rahuljeyaraj/spellbound-sweets/print/skull-nose.3mf

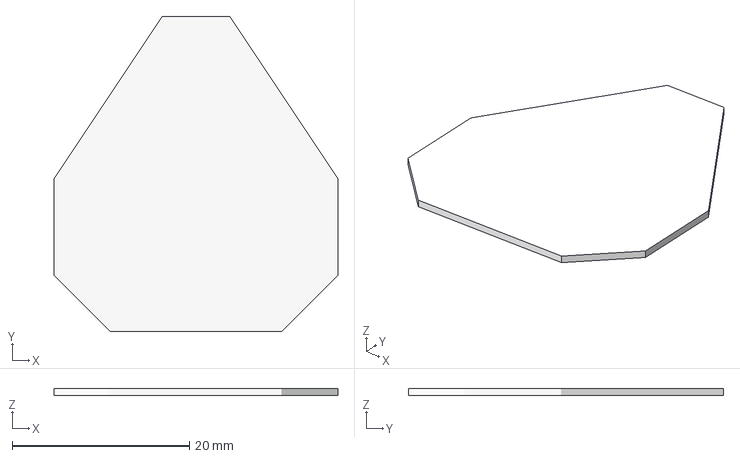
[picture p1: CAD file, 2026-11-06]
print/skull-nose.3mf
32.0 x 35.5 x 0.8 mm
