rahuljeyaraj/spellbound-sweets/print/skull-eye-led-right.3mf

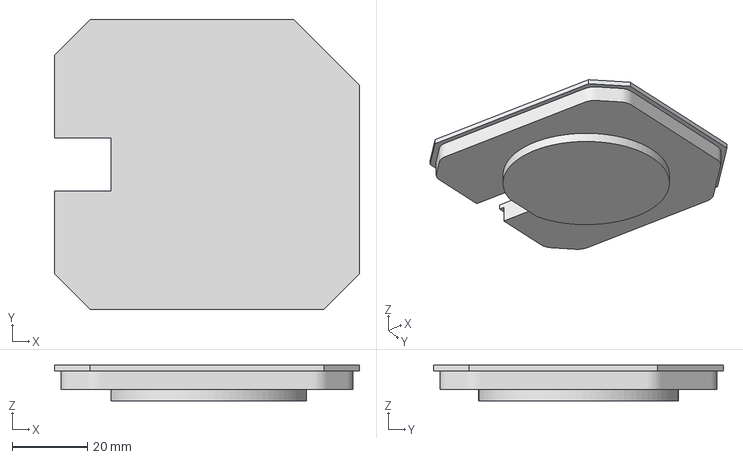
[picture p2: CAD file, 2026-11-06]
print/skull-eye-led-right.3mf
81.0 x 77.0 x 9.50 mm
