rahuljeyaraj/spellbound-sweets/print/skull-mouth.3mf

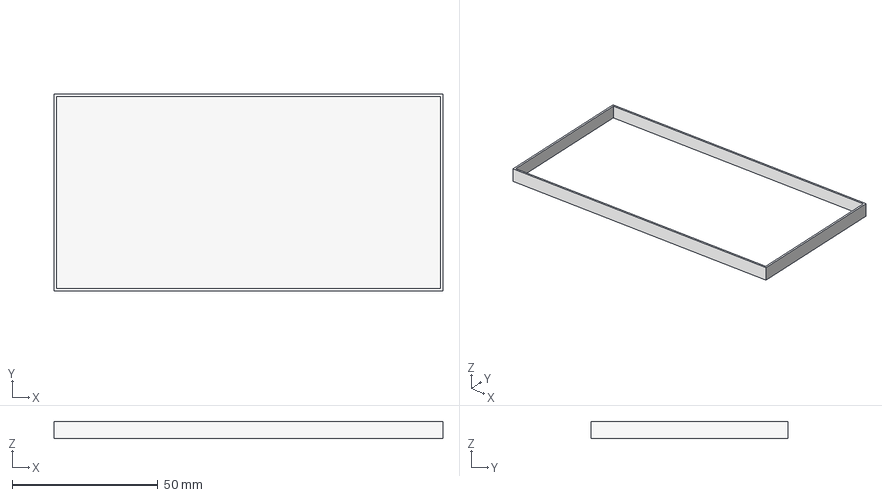
[picture p3: CAD file, 2026-11-06]
print/skull-mouth.3mf
133.6 x 67.6 x 6.00 mm
