rahuljeyaraj/spellbound-sweets/print/skull-jaw.3mf

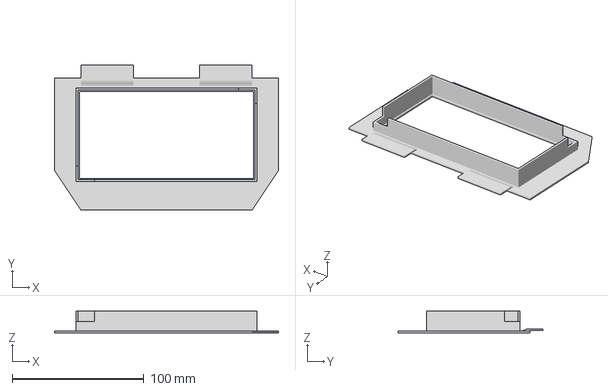
[picture p4: CAD file, 2026-11-06]
print/skull-jaw.3mf
170.0 x 110.0 x 16.5 mm
