rahuljeyaraj/spellbound-sweets/print/skull-eye-right.3mf

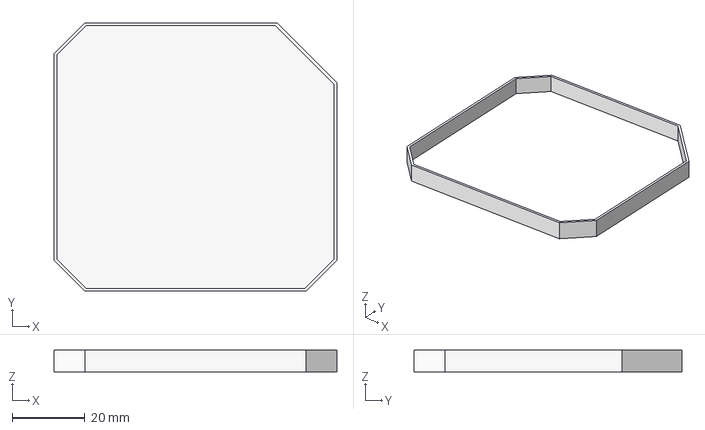
[picture p5: CAD file, 2026-11-06]
print/skull-eye-right.3mf
77.8 x 73.8 x 6.00 mm
