rahuljeyaraj/spellbound-sweets/print/skull-head.3mf

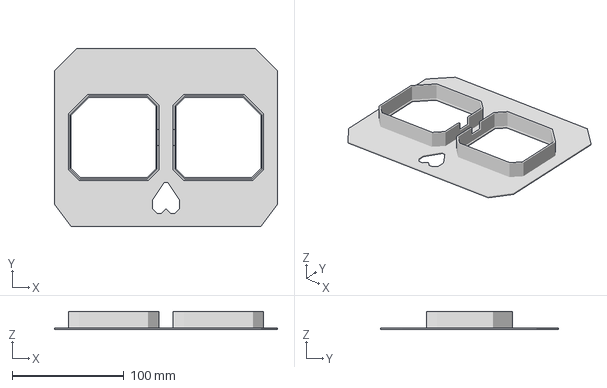
[picture p6: CAD file, 2026-11-06]
print/skull-head.3mf
200.0 x 160.0 x 16.5 mm
