rahuljeyaraj/spellbound-sweets/print/skull-mouth-led.3mf

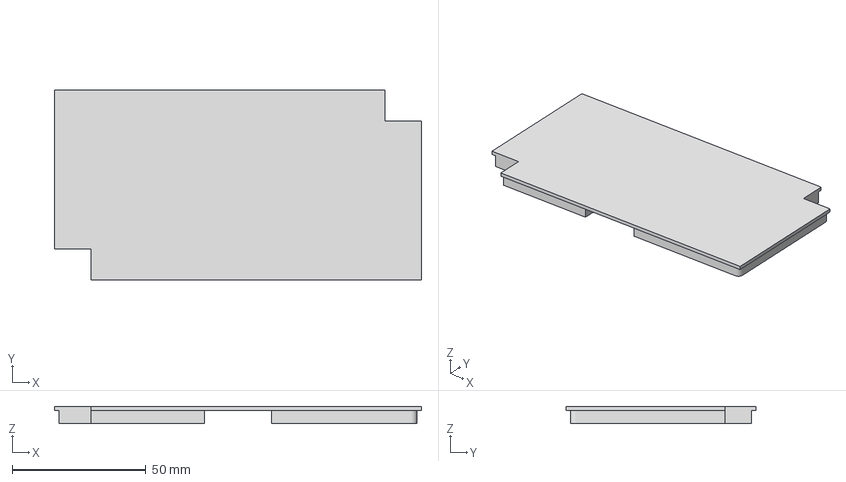
[picture p7: CAD file, 2026-11-06]
print/skull-mouth-led.3mf
137.0 x 71.0 x 6.50 mm
