rahuljeyaraj/spellbound-sweets/print/bowl-lid.3mf

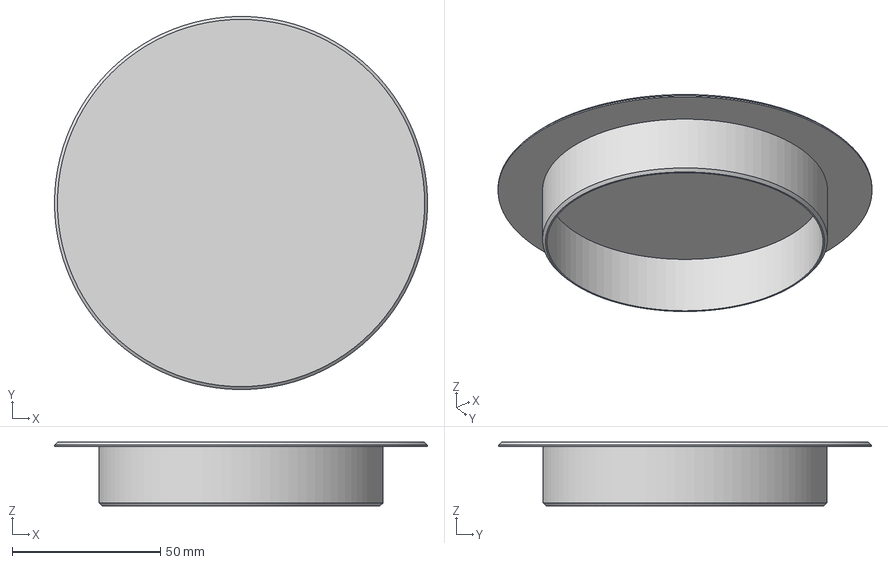
[picture p8: CAD file, 2026-11-06]
print/bowl-lid.3mf
126.0 x 126.0 x 21.5 mm
