rahuljeyaraj/spellbound-sweets/print/try-this-sign.3mf

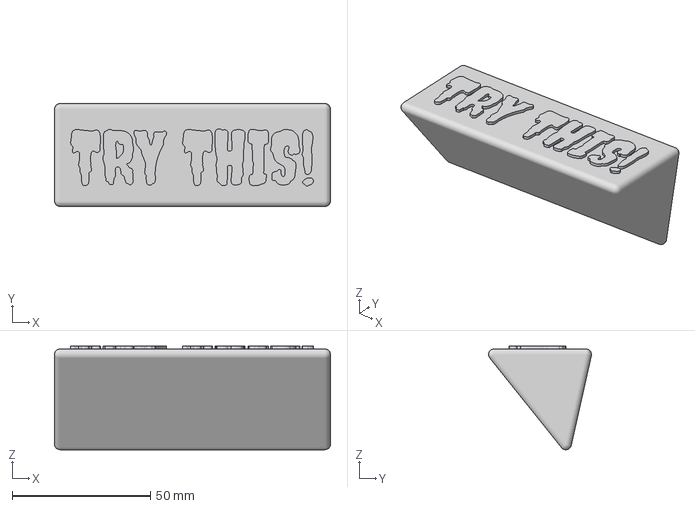
[picture p9: CAD file, 2026-11-05]
print/try-this-sign.3mf
100.0 x 37.3 x 37.5 mm
