rahuljeyaraj/spellbound-sweets/print/hand-and-sign-base.3mf

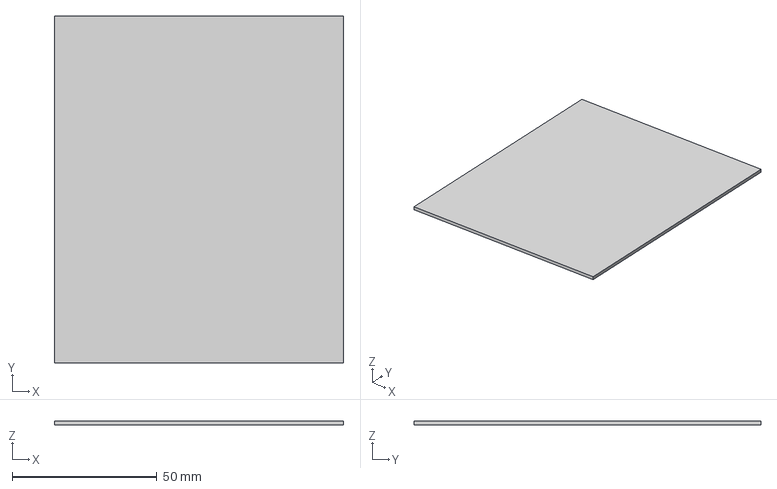
[picture p10: CAD file, 2026-11-05]
print/hand-and-sign-base.3mf
100.0 x 120.0 x 1.50 mm
