rahuljeyaraj/spellbound-sweets/(list of files, cad)

Other CAD files:
print/skull-eye-left.3mf
print/skull-eye-led-left.3mf
