rahuljeyaraj/spellbound-sweets/(commit log)

2026-10-29 Y axis test scripts and two-camera 3D hand tracking
    Y axis: y_sweep.py homes and sweeps the bed; y_speed.py climbs a speed
    ladder and checks for lost steps.
    Stereo hand tracking with two webcams and MediaPipe:
    - view.py shows both cameras for aiming
    - make_board.py writes the A4 checkerboard PDF
    - stereo_calibrate.py calibrates both cameras and the table plane, with
    live board detection and hands-free capture
    - hand3d.py triangulates MediaPipe hand points, follows each hand across
    frames, and shows height above the table on a live map and graph
    [hand3d.py, make_board.py, stereo.py, stereo_calibrate.py, view.py, y_speed.py, y_sweep.py]
2026-10-30 Bowl marker PDF: one 60 mm ArUco marker for the moving bed
2026-10-30 Bowl marker: 50 mm square, 5 mm band, 60 mm cut piece
2026-10-30 Marker sheet: 50 mm (id 0) and 40 mm (id 1) to try on the cameras
2026-10-30 Bowl calibration: find the Y axis from the bed marker at start-up
2026-10-30 Live view: markers in the hand view and the bowl calibration window; 30 mm marker
    hand3d.py now outlines bed markers, lists their 3D positions and draws the Y rail on
    the map. bowl_calibrate.py shows both cameras live through homing, moves and results.
    Marlin.send takes an idle callback so the window stays live during moves.
    make_marker.py takes --ids and --band (default: 40 and 30 mm, 2 mm band).
2026-10-30 Back to the 50/40 mm marker sheet with a 5 mm band; drop the 30 mm marker
2026-10-30 Rim lid: lid.pdf (marker 0 in a 150 mm circle) and rim_calibrate.py
    The rim offset from the base marker is saved along/across/up the rail, and
    hand3d.py draws the rim live and gives each hand's distance to it.
2026-10-30 Lid marker gets its own id (2); ignore any marker id seen twice
    Base and lid were both id 0, so each camera kept a different copy and the
    pair triangulated to nonsense (54 px error).
    [bowl_calibrate.py, make_marker.py, rim_calibrate.py, stereo.py]
2026-10-30 Lid card 145 mm across
2026-10-30 Draw the rim ring in both camera views; --hold for calibration windows
2026-10-30 dodge.py: the bowl dodges a reaching hand
    Hands in rail coordinates around the rim; bowl position from the axis and its
    speed curve; dodge to the far side of the hand; drift back to rest; marker vs
    axis lost-step check; full live view; dry run without --port.
    [dodge.py]
2026-10-30 dodge: fix lost steps from the marker (G92) instead of stopping; --spread
    800/8000 lost steps on long moves with the bowl on.
    [dodge.py]
2026-10-30 dodge: always jump to the rail end furthest from the hand
    Short steps looked like the bowl following the hand.
    [dodge.py]
2026-10-30 dodge: hysteresis, and never move into a hand below the rim
    Points below the rim don't trigger; any in the bowl or its path keep it still.
    After a move the hand must come --hyst mm closer before the next dodge.
    Defaults now 700 mm/s, 7000 mm/s2, trigger 250 mm.
2026-10-30 dodge: re-home on lost steps instead of G92
    G92 shifted Marlin's soft limits, so the stall point became a wall the bowl
    would not pass (Min Y143.9 seen after a hand hit).
    [dodge.py]
2026-10-30 dodge: re-anchor the rail on the marker after every home
    A 9 mm shift of the printer since calibration made every slip check fail and
    re-home forever. Now each home measures the marker at Y20 and re-places the
    rail; a sideways move asks for bowl_calibrate.py.
    [dodge.py]
2026-10-30 dodge: a hand over the opening always triggers, whatever the hysteresis
    A hand that followed the bowl ended up needing to come within -9 mm.
2026-10-30 dodge: random feints - part of the way, then dart back
    --feint (default 0.3) of dodges go 40-80% of the way then return to 0-40 mm
    from the start, so a hand following the bowl is caught out. Return skipped if
    a low hand is in the way.
    [dodge.py]
2026-10-30 dodge: creep back to rest in 12 mm hops so a new hand is dodged at once
2026-10-30 dodge: review fixes; the bowl only waits at the two ends
    - Feint return is called off if a hand is over the spot it would go back to
    (a hand that did not follow); the bowl goes on to an end instead.
    - Hysteresis survives a dropped frame; only 0.5 s with no hand resets it.
    - h clears the "printer moved" banner before re-checking, not after, so a
    failed re-check keeps it up.
    - After a re-home (h or lost steps) the frame from before the home is
    dropped instead of acted on.
    - After homing the bowl waits at Y5, no trip to the middle (--rest gone).
    Stopped anywhere between the ends, it goes on to one once the way is
    clear. Feints dart back to the end they came from.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
    [dodge.py]
2026-10-30 face: browser preview of the LED face and its four moods
    Two 16-LED rings as eyes, two 8x8 boards as a 16x8 mouth. Sleeping while
    waiting, clenched teeth while watching, snapping jaw on snarl, crying when
    it gives up. The moods here are the reference for the LED firmware.
2026-10-31 leds: XIAO RP2350 firmware with the face chain mapped
    One WS2812 chain on D10: right ring, left ring, left and right mouth
    boards, in the order Rahul traced with a chase test. eyeLed() and
    mouthLed() hide the wiring; the layout test shows red tops, green
    3 o'clocks and the mouth's edges.
2026-11-01 leds: the four moods on the face, set over USB by dodge.py
    Sleeping, watching, snarl and crying from the preview. A line with a
    mood letter (s w n c) and an optional hand position, -100 to 100, sets
    the mood and where the eyes look. Until the first line the moods loop
    as a test; if the lines stop for 2 s the face sleeps.
2026-11-01 dodge: horns stop the game; the face plays along
    Horns (index and little finger up, middle and ring folded) seen by
    either camera for 0.3 s: the bowl slides to the middle and the kids
    have 10 s to take a sweet, counted down on screen. The horns must be
    dropped before they count again. HORNS is labelled on each camera
    picture that sees them.
    The face sleeps, watches and follows a hand, snarls on a dodge or a
    hand in the bowl, and cries during a horns stop.
    Also: gain 32 on camera 1, which came out half as bright as camera 0
    at the same exposure; the top view centred on the rail; the picture
    fitted to the window without stretching or jagged text.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
2026-11-01 leds: the ring under the horns hand
    The 8-LED ring chained after the mouth boards, 160 to 167. Off while
    the face sleeps, a slow white breath as the hint while it watches,
    blinking white and red while it snarls, and filling green when the
    horns stop the game. The face's mood drives it, so dodge.py is
    unchanged.
2026-11-01 dodge: count the hands each camera misses; --misses saves the pictures
2026-11-01 sound: the bowl's sounds on the USB speaker, driven by dodge.py
    sound.py mixes live on the speaker's own thread: the hand tone, the skull's
    voice by mood, whooshes fitted to each Axis move, the spell, the night and the
    spot sounds, one reverb, a bass cut and a limiter. dodge.py tells it what
    happens (--sound, --sound-device, --volume, --sound-record). make_sounds.py
    downloads and cuts the set; sound_page.py renders the demo round and writes the
    listening page.
2026-11-01 leds: the snore is timed from falling asleep, so the sound can match the mouth
2026-11-01 sound: the hand tone holds its note on a noisy camera; spot sounds and ducking skip the breathing; checks
    [sound.py, sound_check.py]
2026-11-01 sound: loads in under a second; its own random numbers on dodge.py's side; a short --resume still ends the music box on time
    [sound.py]
2026-11-05 dodge: the snarl stays while a hand is near and 3 s after, so the face no longer flicks to watching; grumbles only for a lasting snarl
    [dodge.py, sound.py]
2026-11-05 sound: the hand tone in layers: an octave under, a held root, a ghost above, and a third and fifth that grow into a chord as the hand comes
    Each layer trails the note with its own glide; the tone keeps the same loudness however many sound.
    Its own commit so it can be reverted alone.
    [sound.py]
2026-11-05 dodge: the shake hops 25 mm and only for a hand at least 2 cm below the rim, not one over the bowl
2026-11-05 leds: the hint ring under the horns hand glows yellow, not white
2026-11-05 print: the "try this" sign for the horns hand; the VS Code workspace for both folders
2026-11-05 dodge: an exposure per camera (e.g. auto -5); camera 0 is dim on a locked exposure in evening light but bright on auto at 30 fps
    Measured: camera 1 drops to 16 fps at -4 and 8 at -3, so it stays at -5 with gain 64.
2026-11-05 dodge: cameras on auto exposure; a locked exposure looked different every run because the driver keeps auto's last gain
    Both cameras hold 30 fps on auto in room light. Calibrate the bowl before every start.
2026-11-05 print: the TRY THIS! sign and the base plate for the horns hand and sign
    [hand-and-sign-base.3mf, try-this-sign.3mf]
2026-11-05 dodge: many hand finders at once (finders.py); calibrates the rail itself when the printer moved
    Camera 0 missed most hands: MediaPipe shrinks the whole frame to 192 px to find palms, and from
    its angle a 200 px hand was too small. finders.py runs the whole frame, follow crops, guided
    crops along the other camera's line of sight and sweep tiles in parallel and merges them. On
    the saved misses camera 0 paired 130 hands instead of 33; --plain keeps the old detector.
    When anchoring finds the printer moved sideways, dodge now calibrates the rail in its own
    window (bowl_calibrate's fit and check, shared) instead of showing a banner; --calibrate does
    it at start-up.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
    [bowl_calibrate.py, dodge.py, finders.py]
2026-11-05 finders: give up on a lone hand that stays put for 0.5 s until it moves
    Rahul's hands on his keyboard, seen by camera 1 and only cut off at camera 0's edge, kept the
    guided crops busy for a whole run: 90% of hand frames were camera 1 only and it ran at 21 frames
    a second. A spot is remembered for a second after its hand was last seen. Replaying the saved
    misses for a second each still pairs the same hands (207 vs 208).
2026-11-06 print: Rahul's skull face parts and the plain bowl lid; README credits the sign's font (Creepster) and the hand's CC version
    [bowl-lid.3mf, skull-eye-led-left.3mf, skull-eye-led-right.3mf, skull-eye-left.3mf, skull-eye-right.3mf, skull-head.3mf, skull-jaw.3mf, skull-mouth-led.3mf]
2026-11-06 print: drop the two sign SVGs not used (plain Arial Rounded, two-line spooky)
2026-11-06 dodge: face wakes only for a hand near the bowl, shake needs the palm low; --sound-only and --no-dodge for filming
    The face woke for any hand either camera saw anywhere, even feet and hands across the room. Now only a 3D hand within --wake (450) mm of the rim centre wakes it, and the eyes and the hand tone ignore hands further off.
    The shake fired for a hand resting on top of the bowl: one fingertip over the edge counted as 20 mm below the rim. Now the palm (wrist and knuckles) must be --shake-below mm down; each shake logs the palm height. Seen on the table: no shake for a hand on top, a shake with the palm at -43 mm.
    --sound-only plays only the named sound groups or single sounds (backgrou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
2026-11-06 bowl_calibrate: --rim does the rail and the rim in one go, --wait-key holds until a key; the log in a panel under the cameras
    For filming the calibration: the log, the status and each marker's 3D position now sit in a panel under the two camera views instead of over the pictures, long lines wrapped. --rim RADIUS measures the rim (rim_calibrate.py's measure_rim, now shared) straight after a GOOD rail, with the lid card riding on the bowl; the lid card's marker is never picked as the base. --wait-key (also on rim_calibrate.py) holds everything until a key is pressed in the window, time to start a screen recording. Run twice on the table: rail GOOD, rim found.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
2026-11-06 leds: a held photo pose, p: the snarl with the jaw wide, no flicker, the hand ring solid yellow; scripts/face_photo.py sets it
